DL7AD/pecanpico8/README.md

# pecanpico8
APRS camera tracker for balloons
