DL7AD/pecanpico8/hardware/output/pecanpico8.pdf

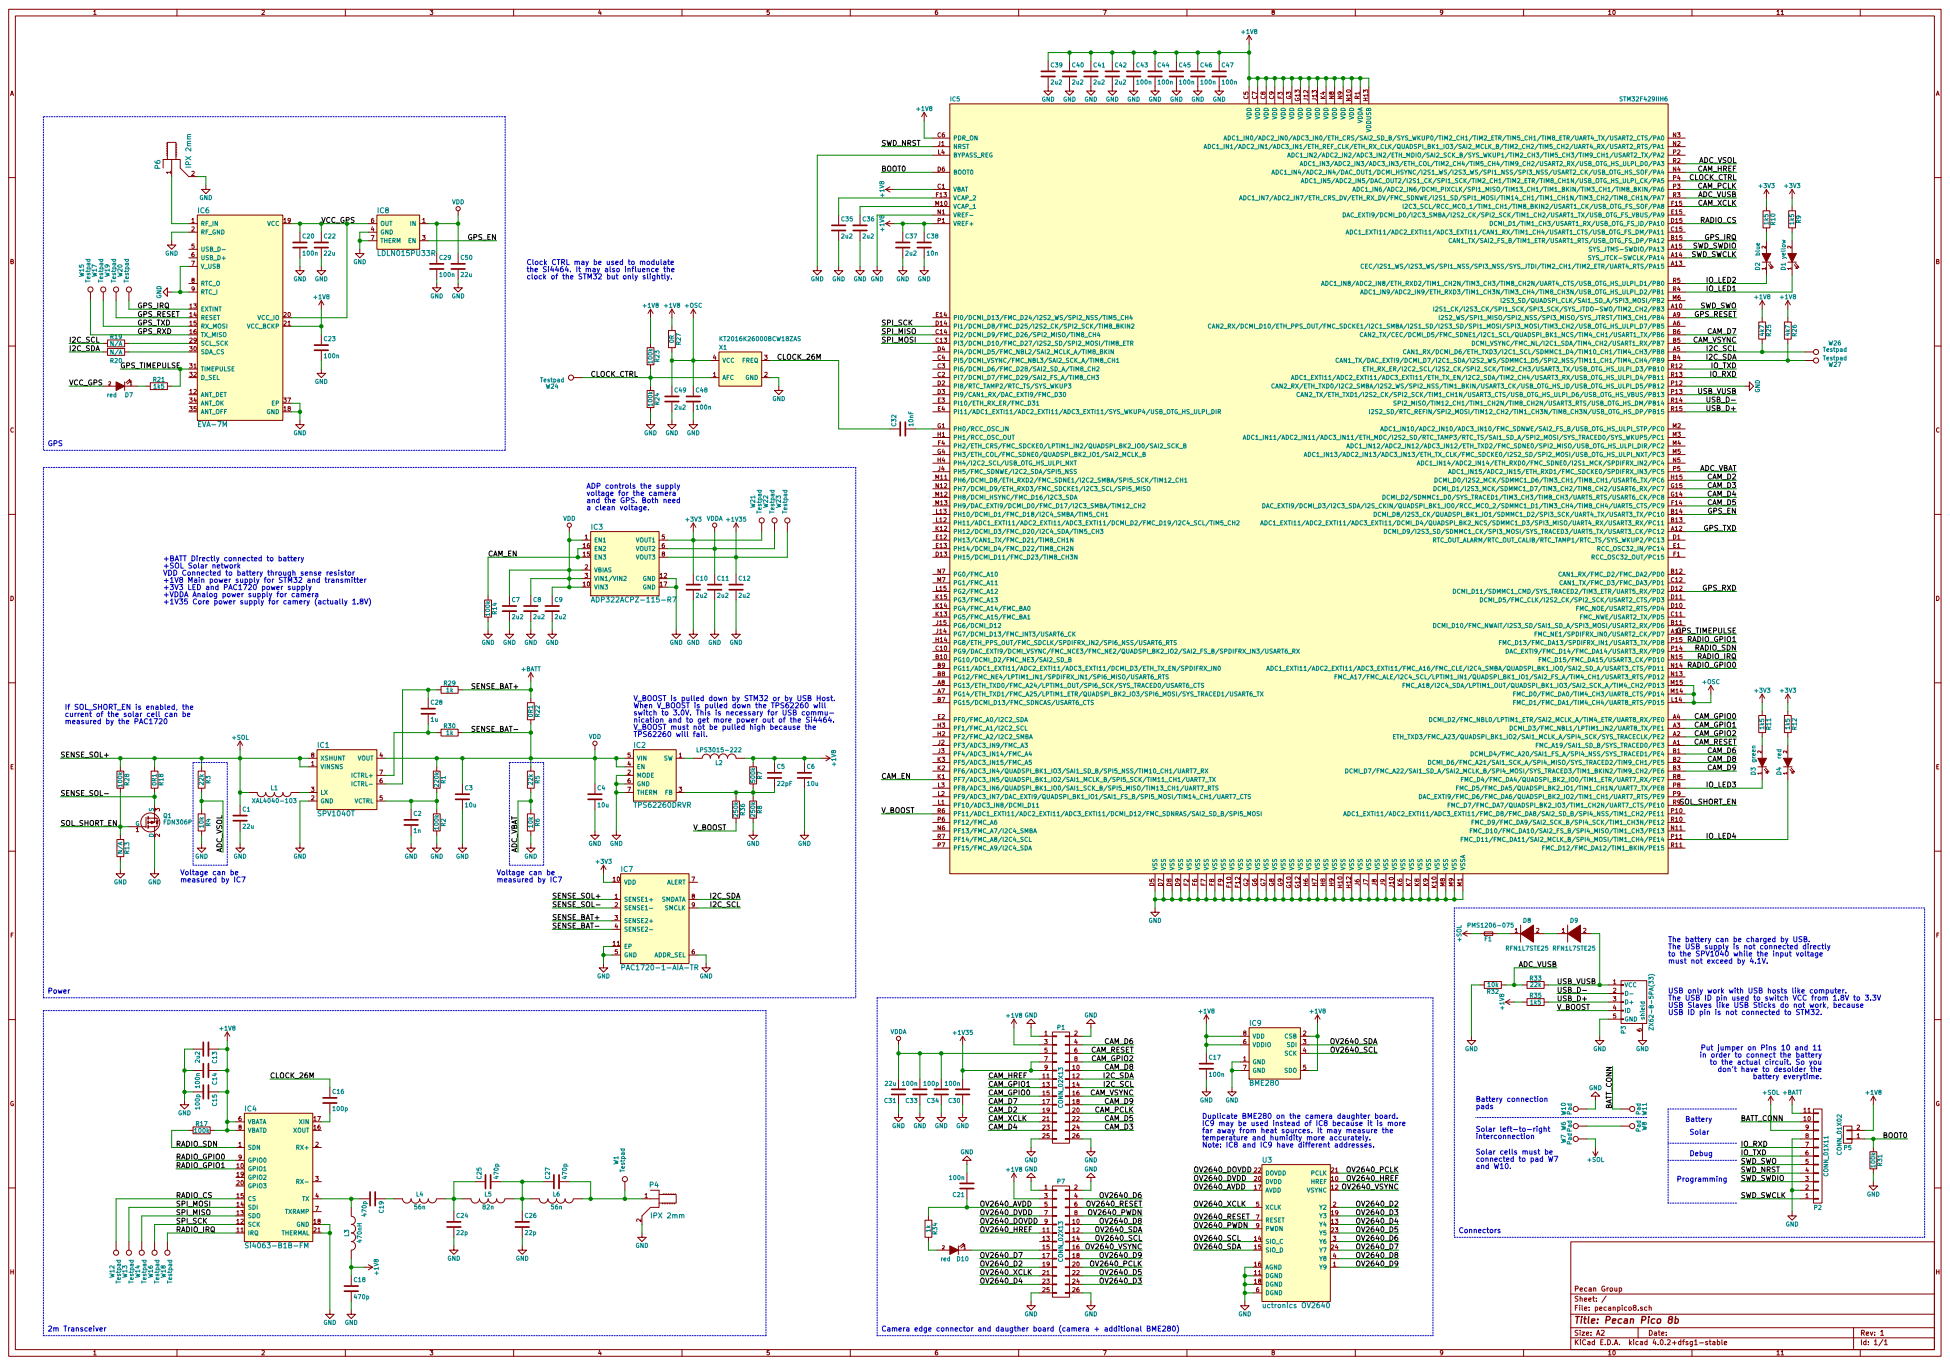
[picture p8: page 1]

IN 1 EN 3 GND 4 OUT 6 THERM 7

Clock CTRL may be used to modulate
the Si4464. It may also influence the
clock of the STM32 but only slightly.

ADP controls the supply
voltage for the camera
and the GPS. Both need
a clean voltage.

+BATT Directly connected to battery
+SOL Solar network
VDD Connected to battery through sense resistor
+1V8 Main power supply for STM32 and transmitter
+3V3 LED and PAC1720 power supply
+VDDA Analog power supply for camera
+1V35 Core power supply for camery (actually 1.8V)

V_BOOST is pulled down by STM32 or by USB Host.
When V_BOOST is pulled down the TPS62260 will
switch to 3.0V. This is necessary for USB commu-
nication and to get more power out of the Si4464.
V_BOOST must not be pulled high because the
TPS62260 will fail.

If SOL_SHORT_EN is enabled, the
current of the solar cell can be measured by the PAC1720 N/A R13 GND
GND 100k R28

SOL_SHORT_EN W18 Testpad W16 Testpad W14 Testpad W13 Testpad W12 Testpad

The USB supply is not connected directly
to the SPV1040 while the input voltage

USB only work with USB hosts like computer.
The USB ID pin used to switch VCC from 1.8V to 3.3V
USB Slaves like USB Sticks do not work, because
USB ID pin is not connected to STM32.

Put jumper on Pins 10 and 11
in order to connect the battery
to the actual circuit. So you
don't have to desolder the
11 P2 CONN_01X11

Duplicate BME280 on the camera daughter board.
IC9 may be used instead of IC8 because it is more
far away from heat sources. It may measure the
temperature and humidity more accurately.
Note: IC8 and IC9 have different addresses.

Solar left-to-right
interconnection Solar cells must be

File: pecanpico8.sch Sheet: / Pecan Group

Id: 1/1 Title: Pecan Pico 8b
