DL7AD/pecanpico8/software/modules/tracking.h

#ifndef __TRACKING_H__
#define __TRACKING_H__

#include "ch.h"
#include "hal.h"
#include "ptime.h"

#define LOG_FLASH_ADDR1		0x080C0000	/* Log flash memory address 1 */
#define LOG_FLASH_ADDR2		0x080E0000	/* Log flash memory address 2 */
#define LOG_SECTOR_SIZE		(128*1024)	/* Log flash memory size */

typedef struct {
	uint32_t id;			// Serial ID
	ptime_t time;			// GPS time

	// GPS
	bool gps_lock;			// True = on last try GPS has been locked
	int32_t gps_lat;		// Latitude in °*10^7
	int32_t gps_lon;		// Longitude in °*10^7
	int32_t gps_alt;		// Altitude in meter
	uint8_t gps_sats;		// Satellites used for solution
	uint8_t gps_ttff;		// Time to first fix in seconds

	// Voltage and current measurement
	uint16_t adc_vsol;		// Current solar voltage in mV
	uint16_t adc_vbat;		// Current battery voltage in mV
	uint16_t adc_vusb;		// Current USB voltage in mV
	int16_t adc_pbat;		// Average battery current (since last track point)
	int16_t adc_psol;		// Current solar shot current

	// BME280 (on board)
	uint32_t air_press;		// Airpressure in Pa*10 (in 0.1Pa)
	uint16_t air_hum;		// Rel. humidity in %*10 (in 0.1%)
	int16_t air_temp;		// Temperature in degC*100 (in 0.01°C)
} trackPoint_t;

void waitForNewTrackPoint(void);
trackPoint_t* getLastTrackPoint(void);
void getNextLogTrackPoint(trackPoint_t* log);
void init_tracking_manager(void);

#endif
