DL7AD/pecanpico8/software/drivers/wrapper/pi2c.h

/**
  * I2C wrapper for ChibiOS due to a bug: I2C blocking when I2C transfer suffered timeout
  * @see https://github.com/psas/stm32/commit/32ec8c97a1e5bf605bd5d41a89fc60b60e136af2
  */

#ifndef __I2C_H__
#define __I2C_H__

#include "ch.h"
#include "hal.h"
#include "debug.h"
#include "config.h"

void pi2cInit(void);

// I2C Mutex locked access functions (Access only if I2C has been locked with I2C_lock())
bool I2C_write8_locked(uint8_t address, uint8_t reg, uint8_t value);
bool I2C_writeN_locked(uint8_t address, uint8_t *txbuf, uint32_t length);
bool I2C_read8_locked(uint8_t address, uint8_t reg, uint8_t *val);
bool I2C_read16_locked(uint8_t address, uint8_t reg, uint16_t *val);

// I2C Mutex unlocked access functions
bool I2C_write8(uint8_t address, uint8_t reg, uint8_t value);
bool I2C_writeN(uint8_t address, uint8_t *txbuf, uint32_t length);
bool I2C_read8(uint8_t address, uint8_t reg, uint8_t *val);
bool I2C_read16(uint8_t address, uint8_t reg, uint16_t *val);
bool I2C_read16_LE(uint8_t address, uint8_t reg, uint16_t *val);
bool I2C_readS16(uint8_t address, uint8_t reg, int16_t *val);
bool I2C_readS16_LE(uint8_t address, uint8_t reg, int16_t* val);

// I2C locking and unlocking
void I2C_lock(void);
void I2C_unlock(void);

#endif
