DL7AD/pecanpico8/software/sleep.h

#ifndef __SLEEP_H__
#define __SLEEP_H__

#include "ch.h"
#include "hal.h"
#include "types.h"

#define WAIT_FOR_TRACKING_POINT		trigger_new_tracking_point
#define TX_CONTINUOSLY				trigger_immediately

bool p_sleep(const sleep_config_t *config);
systime_t waitForTrigger(systime_t prev, trigger_config_t *config);
void trigger_new_tracking_point(void);
void trigger_immediately(void);

#endif
