DL7AD/pecanpico8/(commit log)

2016-08-22 Added project files
    [camera.sch, gps.sch, mcu.sch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]
2016-08-31 Increased via dia, moved drillings in panel
    [pecanpico8-B.Cu.gbl, pecanpico8-B.Mask.gbs, pecanpico8-B.Paste.gbp, pecanpico8-B.SilkS.gbo, pecanpico8-Edge.Cuts.gm1, pecanpico8-F.Cu.gtl, pecanpico8-F.Mask.gts, pecanpico8-F.Paste.gtp]
2016-09-04 Moved KiCAD files into hardware folder
    [camera.sch, gps.sch, mcu.sch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]
2016-09-04 Updated Pico8 board configuration
2016-09-04 Adapted code for Pecan Pico 8a, removed buildfiles
2016-09-09 Brought board to work Fixed UART bug Made camera working (hardware fix included) Changed I2C interface
    [board.h, config.c, config.h, debug.h, main.c, mcuconf.h, ov2640.c, padc.c]
2016-09-15 Adapted code for new Pecan Pico 8a board Changed ADC voltage dividers and channels Adapted PAC1720 channels Changed ublox driver to UART Fixed errors in board configuration Renamed telemetry paramete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
    [aprs.c, board.h, config.c, config.h, main.c, max.c, pac1720.c, pac1720.h]
2016-09-16 Done some power saving modifications
2016-10-27 Started developement of rev 8b Changed USB Connector: Mini => Micro Connected CAM_EN to STM32 Added battery jumper switch at programming header Added solar input at programmer header Removed LED outp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
    [pecanpico8.kicad_pcb, pecanpico8.sch]
2017-01-16 GPS
    - GPS Antenna went to the backside, so save space.
    - We also use IPEX connectors for the GPS Antenna instead but you can also solder a wire on the connector pad instead.
    Transmitter
    - The space which I won, went into the LPF of the transceiver.
    - We use an LFCN LPF by Mini-Circuits. They are more expensive (~US$5) but work perfectly for us.
    - We also added a RX/TX switch to it. I did this because an Australian friend found out how to receive AFSK APRS with the Si4464.
    - The transmitter also got that fancy IPEX connector for which you can find prebuild 70cm wire-antennas on Ebay for US$1.
    Camera
    - I discarded the FFC connector and replaced it with a custom 50mil edge-header (on which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
    [camera.sch, gps.sch, mcu.sch, pecanpico8.kicad_pcb, pecanpico8.sch, pecanpico8_panel.kicad_pcb, power.sch, radio.sch]
2017-03-08 Added new LDO for GPS Implemented constant voltage for LEDs Replaced MicroUSB THT connector with SMD connector Replaced LPF
    [pecanpico8.kicad_pcb, pecanpico8.sch]
2017-03-08 Moving parts around
    [pecanpico8.kicad_pcb, pecanpico8.sch]
2017-03-09 Moved signals around, created GERBERs
    [pecanpico8-B.Cu.gbl, pecanpico8-B.Mask.gbs, pecanpico8-B.Paste.gbp, pecanpico8-B.SilkS.gbo, pecanpico8-Edge.Cuts.gm1, pecanpico8-F.Cu.gtl, pecanpico8-F.Mask.gts, pecanpico8-F.Paste.gtp]
2017-04-03 Replaced inductor for SPV1040, added production information, created GERBERs
    [pecanpico8-B.Cu.gbl, pecanpico8-B.Mask.gbs, pecanpico8-B.Paste.gbp, pecanpico8-B.SilkS.gbo, pecanpico8-Edge.Cuts.gm1, pecanpico8-F.Cu.gtl, pecanpico8-F.Mask.gts, pecanpico8-F.Paste.gtp]
2017-04-04 Added solder stop opening below QFN vias Removed copper closer than 0.2mm from the edge of the PCB Created new GERBER files
    [pecanpico8-B.Cu.gbl, pecanpico8-B.Mask.gbs, pecanpico8-B.Paste.gbp, pecanpico8-B.SilkS.gbo, pecanpico8-Edge.Cuts.gm1, pecanpico8-F.Cu.gtl, pecanpico8-F.Mask.gts, pecanpico8-F.Paste.gtp]
2017-04-04 Fixed wrong comment
    [pecanpico8.sch]
